iBehave-CADRE/CADRE-Modular-Open-Maze/README.md

# CADRE-Modular-Open-Maze
An open-source modular behavioral recording maze. 

Affordable to reproduce with a minimum of commercial parts.

Can be 3D-printed or cut from acrylic with a lasercutter.
