iBehave-CADRE/CADRE-Modular-Open-Maze/Door-Module/DXF Files (lasercutting)/Arduino Holder.dxf

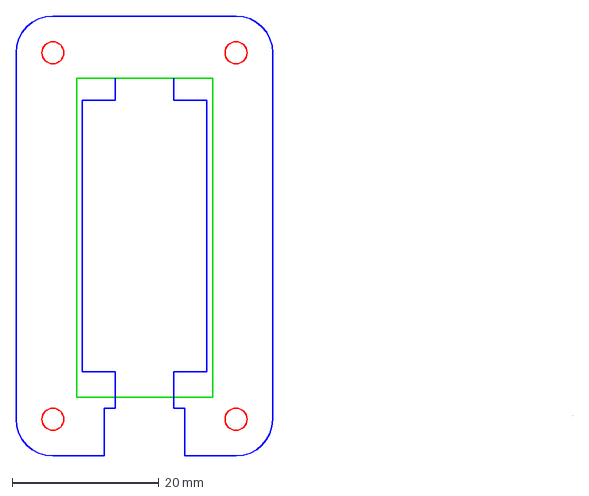
[picture p4: CAD file, 2024-07-16]
Door-Module/DXF Files (lasercutting)/Arduino Holder.dxf
75.9 x 60.0 mm
