iBehave-CADRE/CADRE-Modular-Open-Maze/Door-Module/STEP Files/Electronics Panel.step

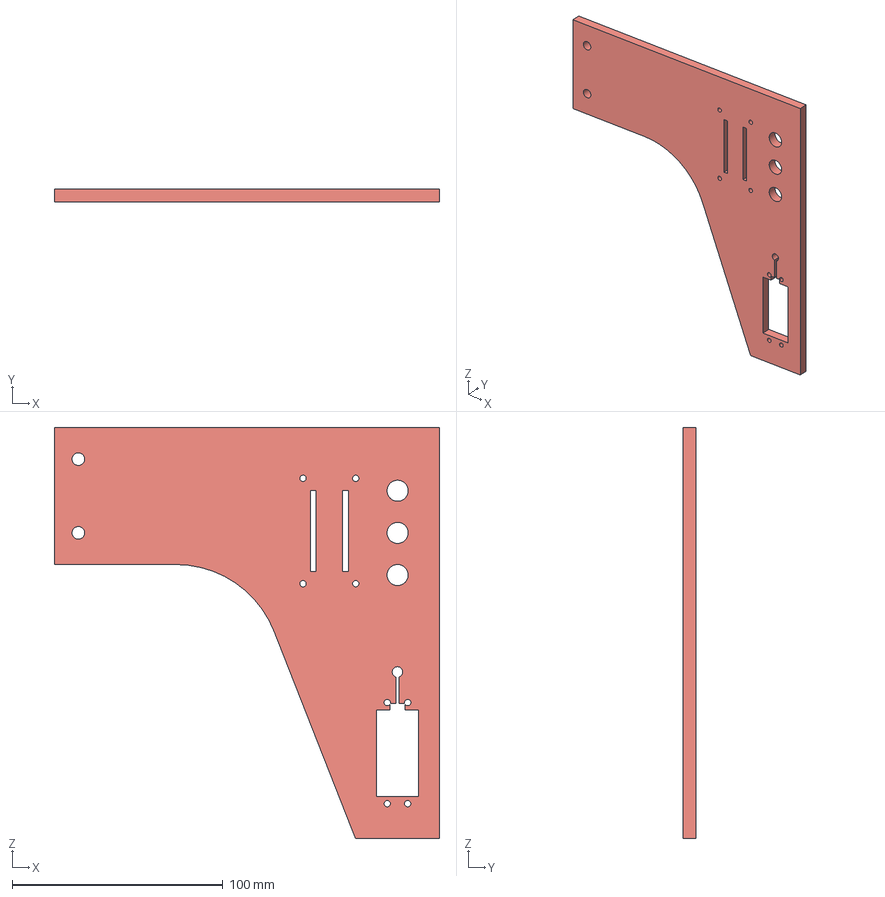
[picture p5: CAD file, 2024-07-16]
Door-Module/STEP Files/Electronics Panel.step
182.9 x 6.00 x 195.0 mm
