iBehave-CADRE/CADRE-Modular-Open-Maze/Door-Module/STL Files/Floor Rest.stl

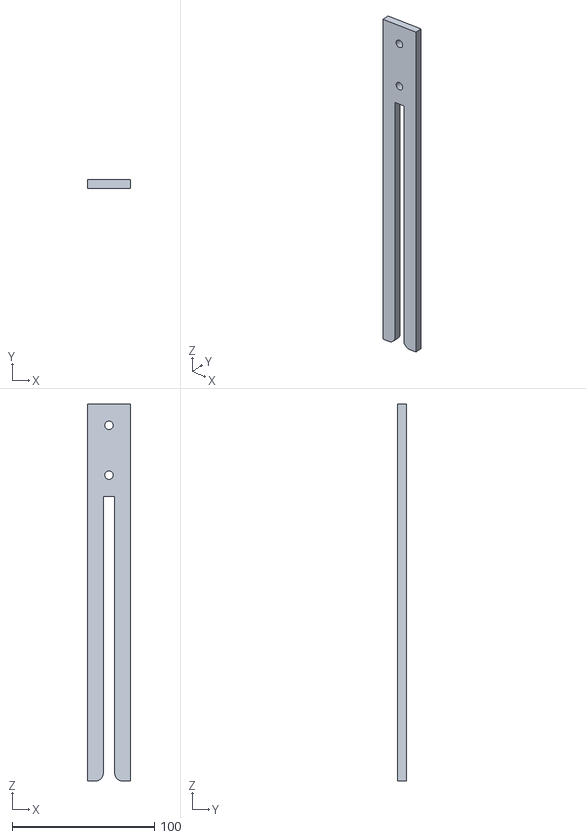
[picture p6: CAD file, 2024-07-11]
Door-Module/STL Files/Floor Rest.stl
30.0 x 6.00 x 265.0
