iBehave-CADRE/CADRE-Modular-Open-Maze/Door-Module/DXF Files (lasercutting)/Electronics Panel.dxf

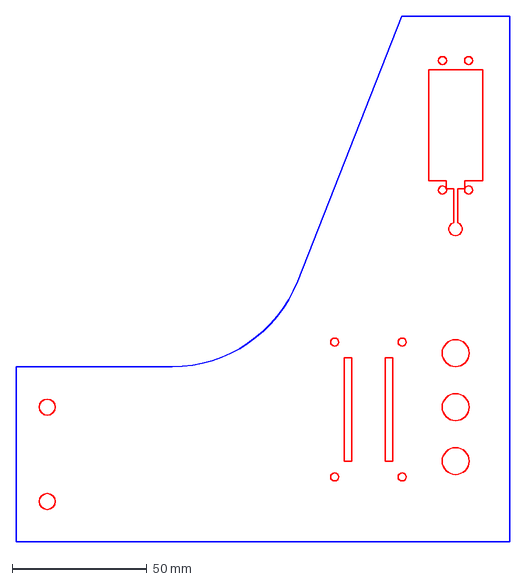
[picture p7: CAD file, 2024-07-16]
Door-Module/DXF Files (lasercutting)/Electronics Panel.dxf
182.9 x 195.0 mm
