iBehave-CADRE/CADRE-Modular-Open-Maze/Door-Module/STEP Files/Arduino Holder.step

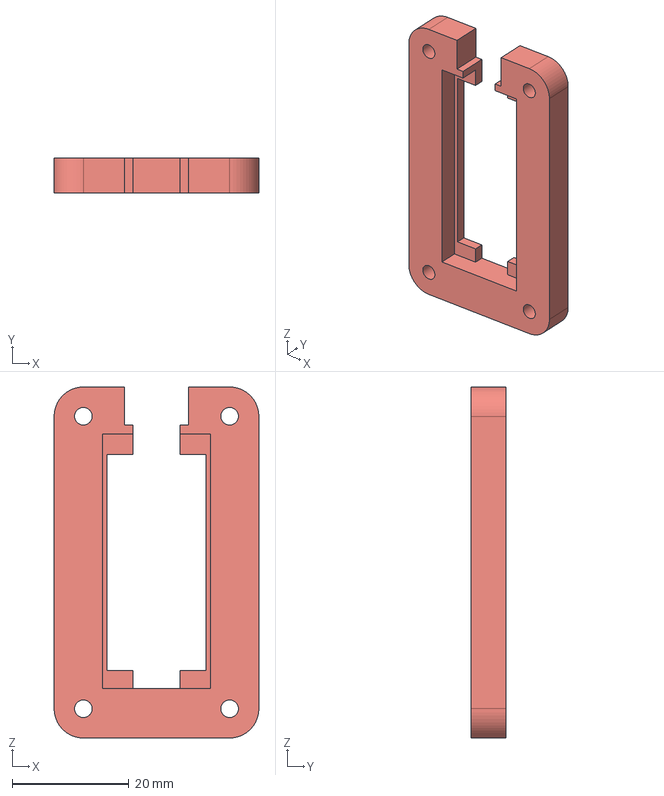
[picture p8: CAD file, 2024-07-16]
Door-Module/STEP Files/Arduino Holder.step
35.0 x 6.00 x 60.0 mm
