iBehave-CADRE/CADRE-Modular-Open-Maze/Door-Module/DXF Files (lasercutting)/Door Panel.dxf

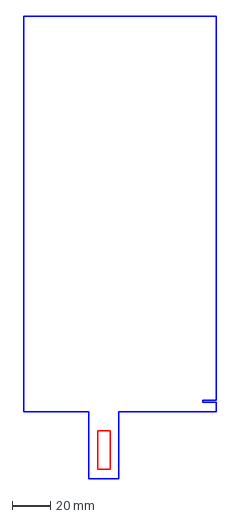
[picture p9: CAD file, 2024-07-11]
Door-Module/DXF Files (lasercutting)/Door Panel.dxf
100.0 x 241.0 mm
