iBehave-CADRE/CADRE-Modular-Open-Maze/Door-Module/STEP Files/Profile Stopper.step

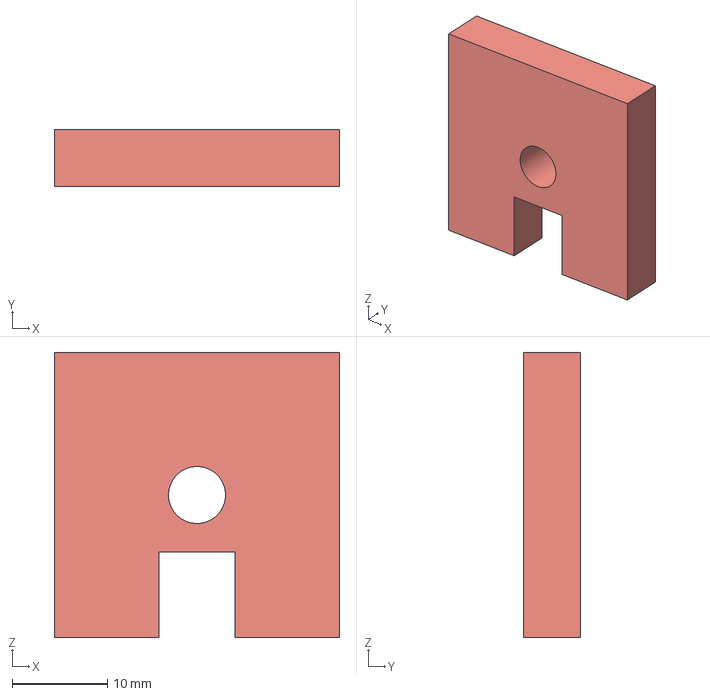
[picture p10: CAD file, 2024-07-11]
Door-Module/STEP Files/Profile Stopper.step
30.0 x 6.00 x 30.0 mm
