iBehave-CADRE/CADRE-Modular-Open-Maze/Door-Module/DXF Files (lasercutting)/Profile Stopper.dxf

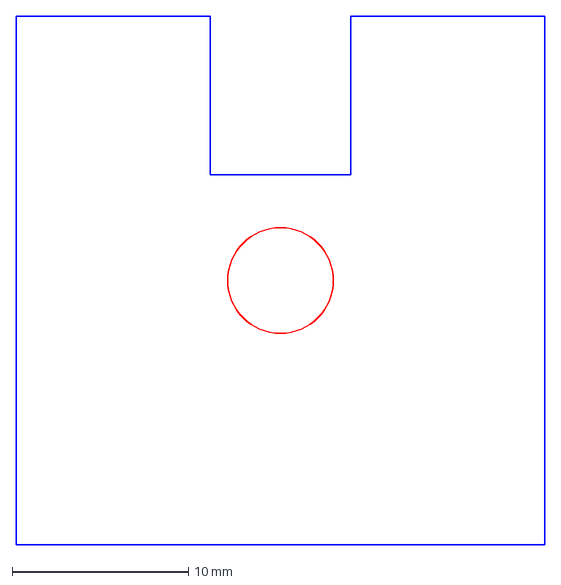
[picture p11: CAD file, 2024-07-11]
Door-Module/DXF Files (lasercutting)/Profile Stopper.dxf
30.0 x 30.0 mm
