iBehave-CADRE/CADRE-Modular-Open-Maze/Door-Module/STEP Files/Counterweight.step

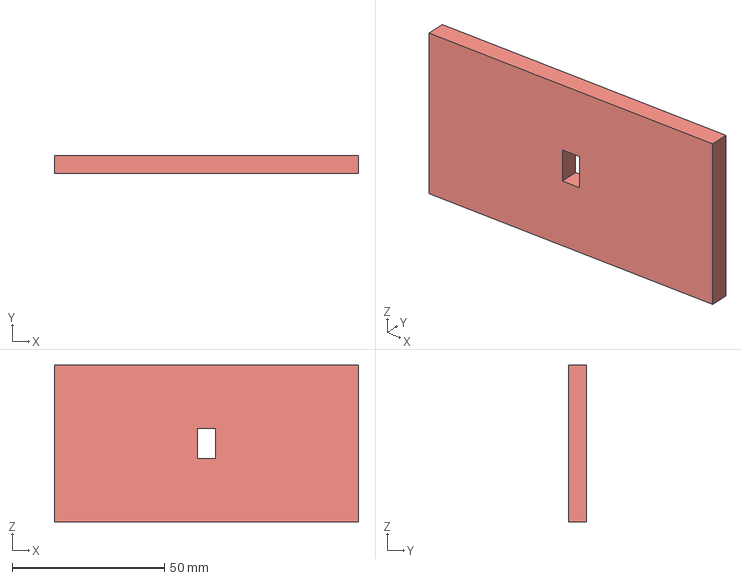
[picture p12: CAD file, 2024-07-11]
Door-Module/STEP Files/Counterweight.step
100.0 x 6.00 x 51.5 mm
