iBehave-CADRE/CADRE-Modular-Open-Maze/Door-Module/DXF Files (lasercutting)/Mock Floor.dxf

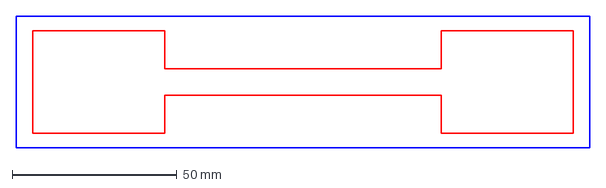
[picture p13: CAD file, 2024-07-11]
Door-Module/DXF Files (lasercutting)/Mock Floor.dxf
174.0 x 40.0 mm
