iBehave-CADRE/CADRE-Modular-Open-Maze/Door-Module/STEP Files/Servo Lever.step

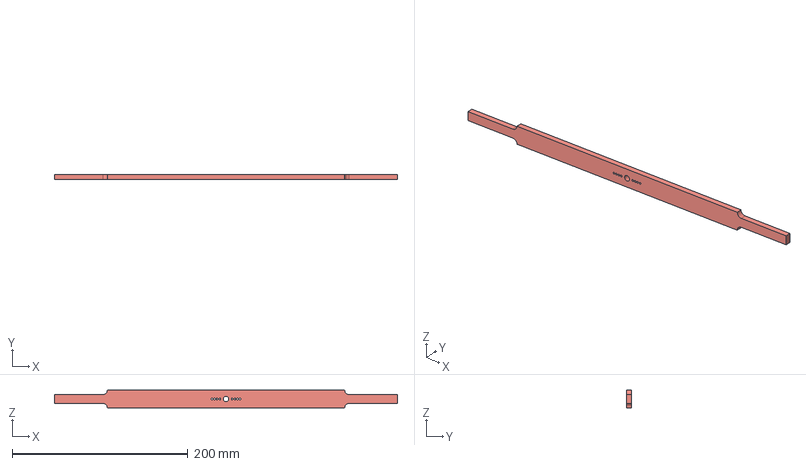
[picture p14: CAD file, 2024-07-11]
Door-Module/STEP Files/Servo Lever.step
390.0 x 6.00 x 20.0 mm
