iBehave-CADRE/CADRE-Modular-Open-Maze/Door-Module/DXF Files (lasercutting)/Servo Lever.dxf

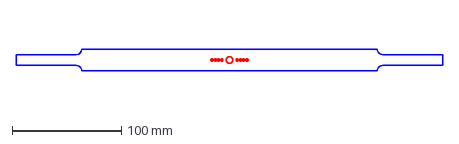
[picture p15: CAD file, 2024-07-11]
Door-Module/DXF Files (lasercutting)/Servo Lever.dxf
390.0 x 20.0 mm
