iBehave-CADRE/CADRE-Modular-Open-Maze/Door-Module/DXF Files (lasercutting)/Floor Rest.dxf

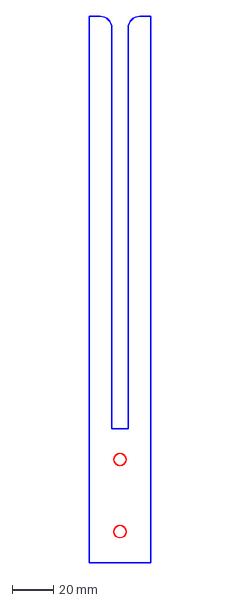
[picture p16: CAD file, 2024-07-11]
Door-Module/DXF Files (lasercutting)/Floor Rest.dxf
30.0 x 265.0 mm
