iBehave-CADRE/CADRE-Modular-Open-Maze/Door-Module/STEP Files/Mock Floor.step

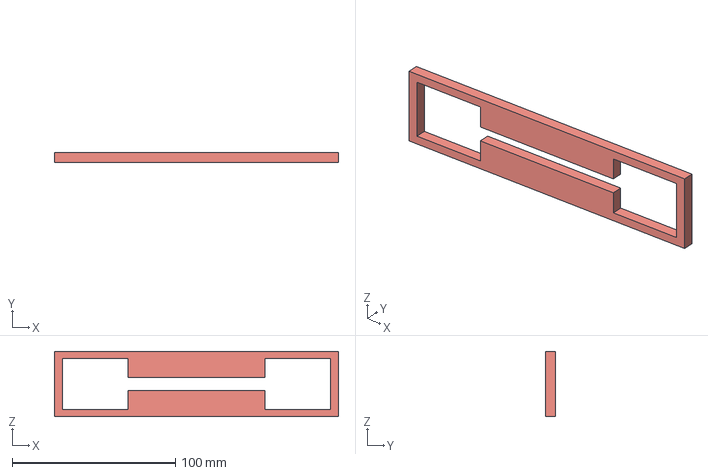
[picture p17: CAD file, 2024-07-11]
Door-Module/STEP Files/Mock Floor.step
174.0 x 6.00 x 40.0 mm
