iBehave-CADRE/CADRE-Modular-Open-Maze/Door-Module/DXF Files (lasercutting)/Counterweight.dxf

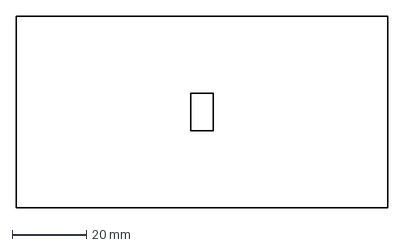
[picture p18: CAD file, 2024-06-12]
Door-Module/DXF Files (lasercutting)/Counterweight.dxf
100.0 x 51.5 mm
