iBehave-CADRE/CADRE-Modular-Open-Maze/Door-Module/STEP Files/Door Panel.step

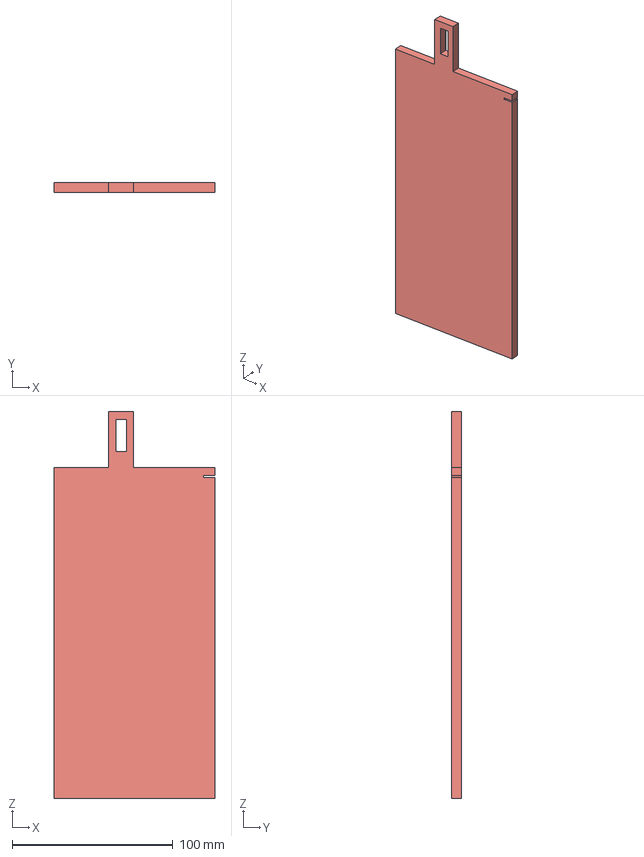
[picture p19: CAD file, 2024-07-11]
Door-Module/STEP Files/Door Panel.step
100.0 x 6.00 x 241.0 mm
