iBehave-CADRE/CADRE-Modular-Open-Maze/(list of files, cad)

Other CAD files:
Door-Module/STEP Files/Floor Rest v8.step
Door-Module/STL Files/Arduino Holder.stl
Door-Module/STL Files/Counterweight.stl
Door-Module/STL Files/Door Panel.stl
Door-Module/STL Files/Electronics Panel.stl
Door-Module/STL Files/Mock Floor.stl
Door-Module/STL Files/Profile Stopper.stl
Door-Module/STL Files/Servo Lever.stl
