iBehave-CADRE/CADRE-Modular-Open-Maze/Door-Module/Door-Module Technical Drawing.pdf

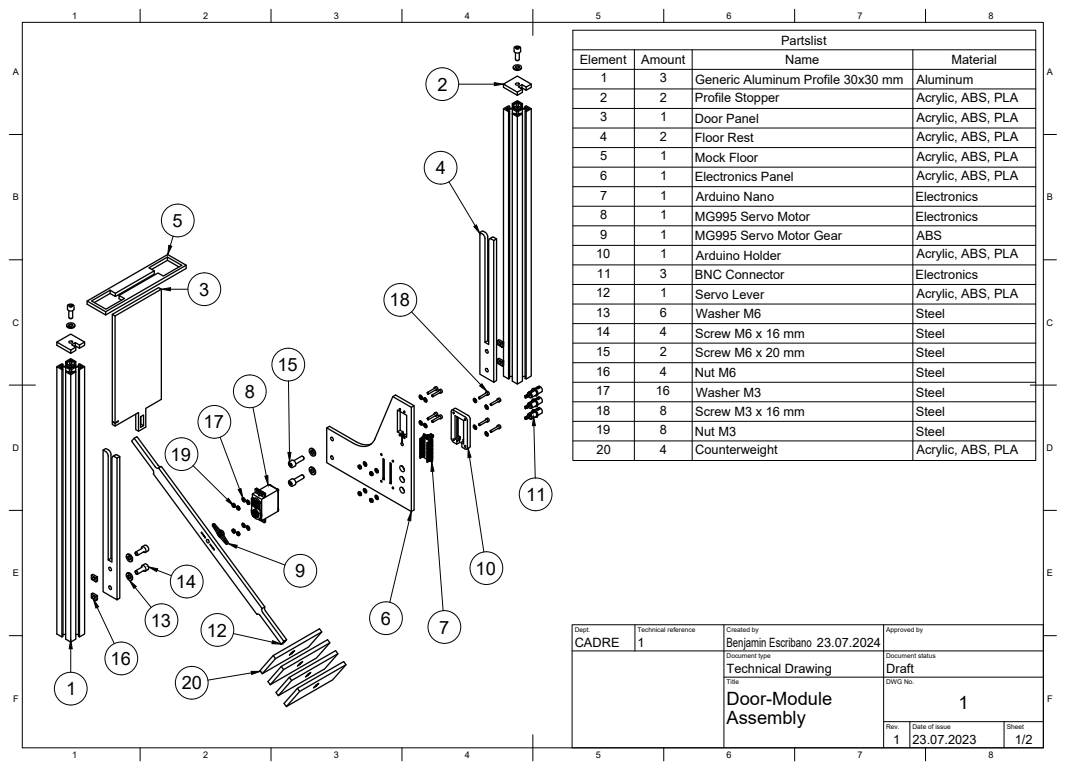
[picture p20: page 1]
8 BCDEF; ABCDEF; Title; DWG No.; Rev.; Date of issue; Sheet 1; Element; Amount; Name; Material 1; Generic Aluminum Profile 30x30 mm; Aluminum 2; Profile Stopper; Acrylic, ABS, PLA 3; Door Panel; Acrylic, ABS, PLA 4; Floor Rest; Acrylic, ABS, PLA 5; Mock Floor; Acrylic, ABS, PLA 6; Electronics Panel; Acrylic, ABS, PLA 7; Arduino Nano; Electronics 8; MG995 Servo Motor; Electronics 9; MG995 Servo Motor Gear; ABS; Counterweight; Acrylic, ABS, PLA 5 3

10 | 1 | Arduino Holder | Acrylic, ABS, PLA
11 | 3 | BNC Connector | Electronics
12 | 1 | Servo Lever | Acrylic, ABS, PLA
13 | 6 | Washer M6 | Steel
14 | 4 | Screw M6 x 16 mm | Steel
15 | 2 | Screw M6 x 20 mm | Steel
16 | 4 | Nut M6 | Steel
17 | 16 | Washer M3 | Steel
18 | 8 | Screw M3 x 16 mm | Steel
19 | 8 | Nut M3 | Steel

Dept. CADRE | Technical reference 1 | Created by Benjamin Escribano 23.07.2024 | Approved by

Document type Technical Drawing | Document status Draft

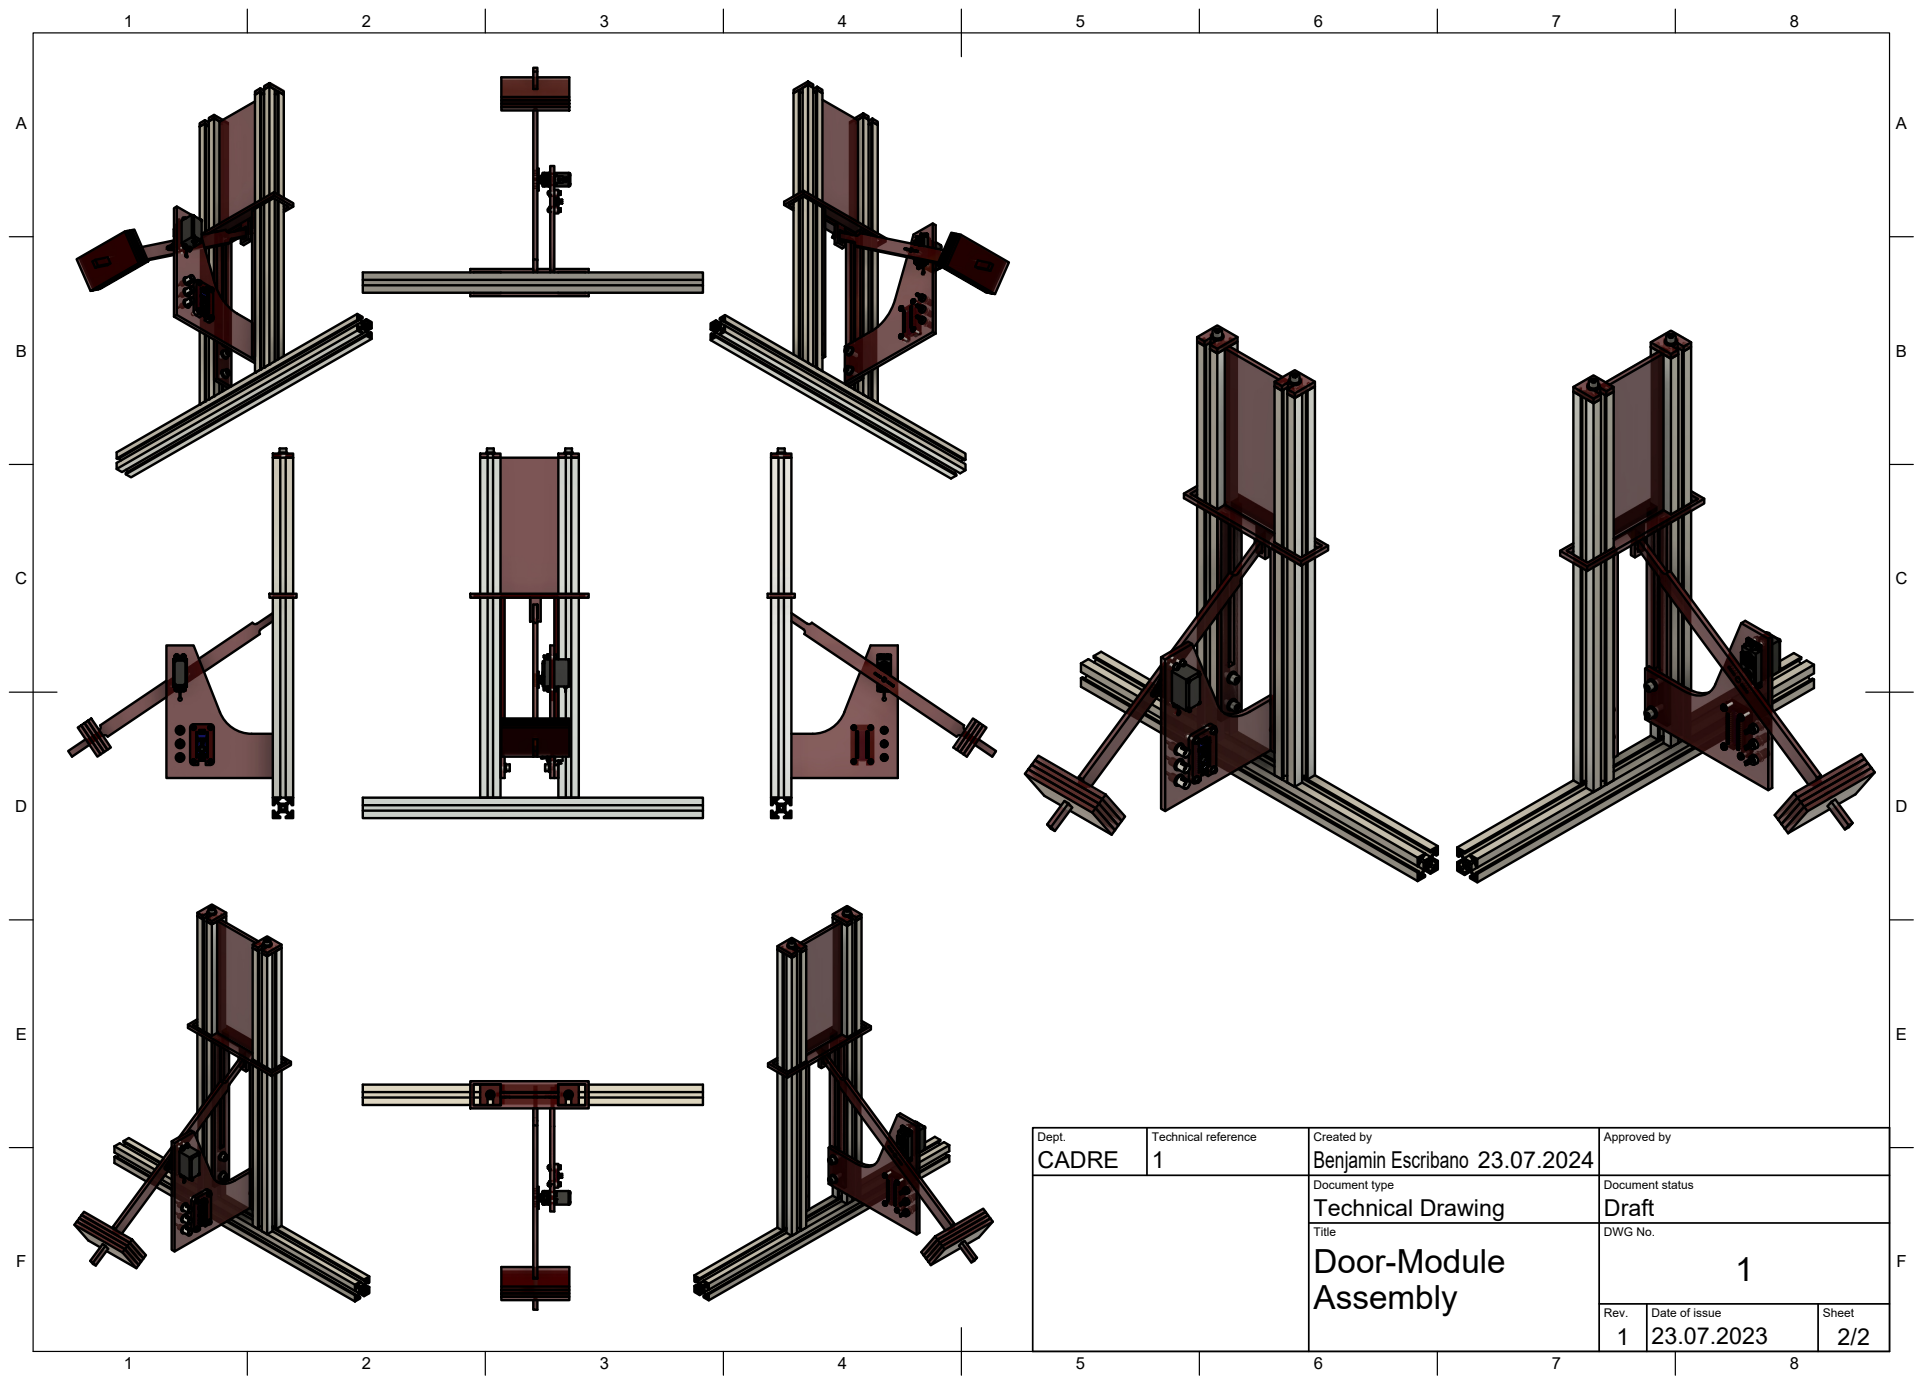
[picture p21: page 2]
Dept.; Technical reference; Created by; Approved by; Document type; Document status; Title; DWG No.; Rev.; Date of issue; Sheet; Technical Drawing; Draft; CADRE; Benjamin Escribano
