iBehave-CADRE/CADRE-Modular-Open-Maze/(commit log)

2024-07-11 Exported Files
    [Arduino Holder.dxf, Arduino Holder.step, Arduino Holder.stl, Counterweight.step, Door Panel.dxf, Door Panel.step, Door Panel.stl, Electronics Panel.dxf]
2024-07-16 update files
    [Arduino Holder.dxf, Arduino Holder.step, Arduino Holder.stl, Electronics Panel.dxf, Electronics Panel.step, Electronics Panel.stl]
